nathanpaulscott/IOT-Weather-Station/Datasheets/sunflower schematic.png

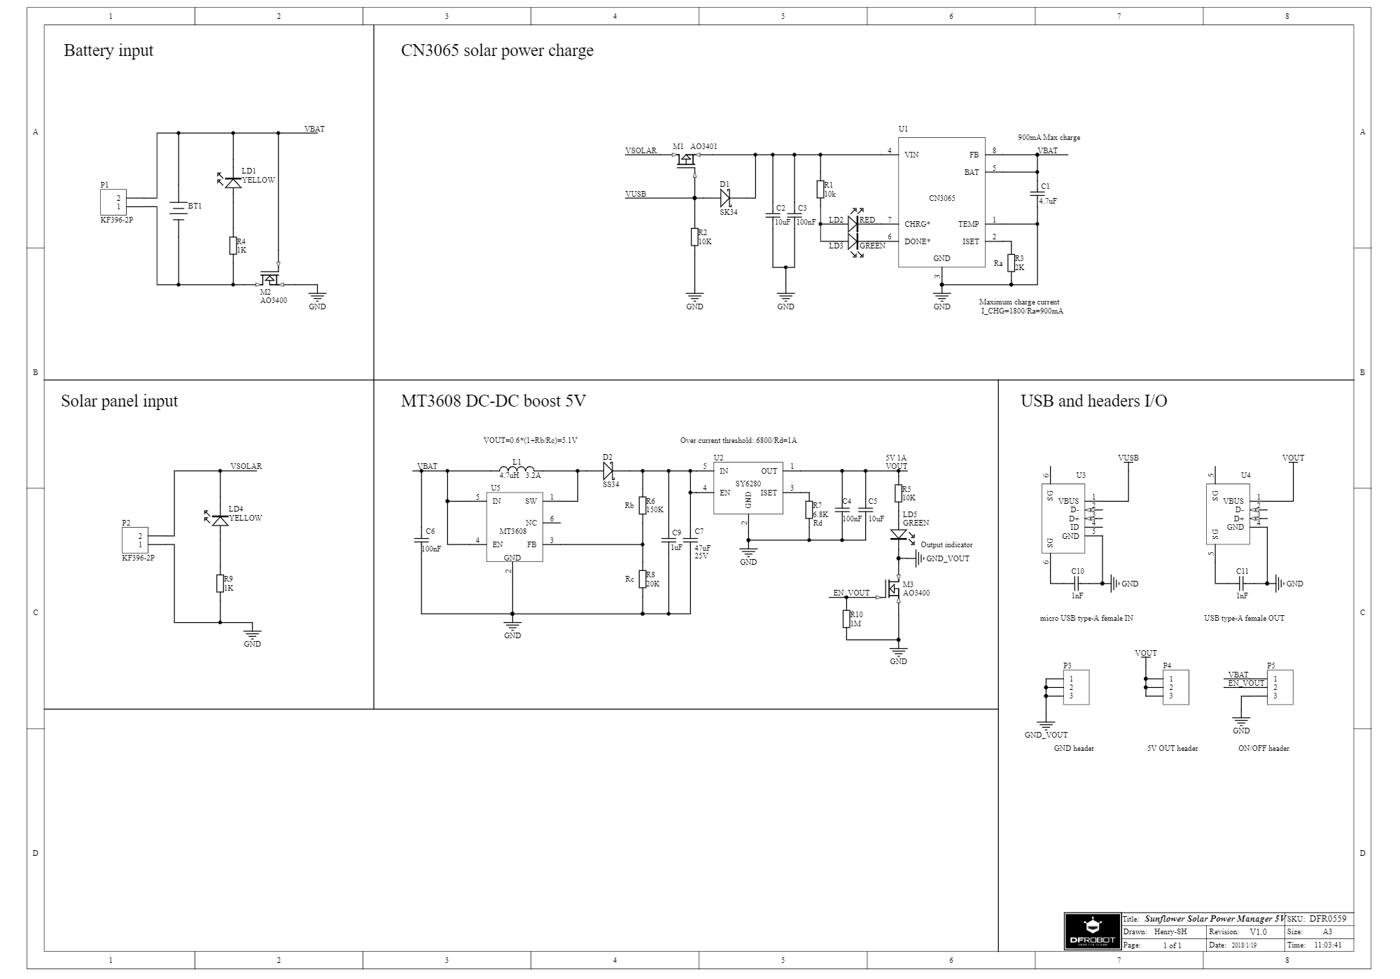
Datasheets/sunflower schematic.png
