nathanpaulscott/IOT-Weather-Station/Report/0a.RP Server.jpg

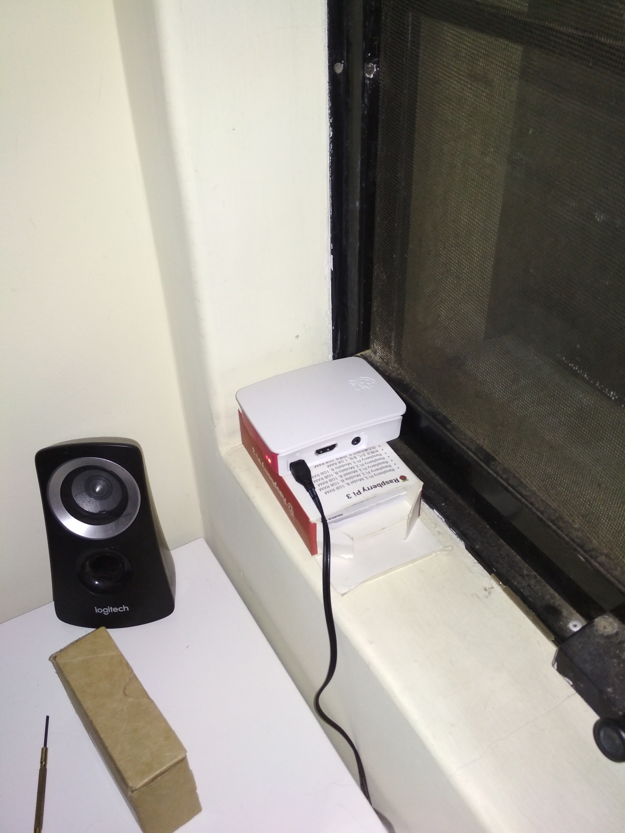
Report/0a.RP Server.jpg
