nathanpaulscott/IOT-Weather-Station/Report/breadboard 1.png

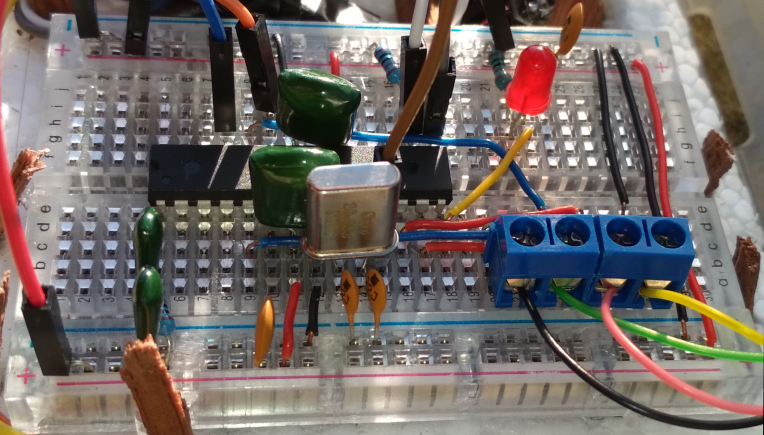
Report/breadboard 1.png
