nathanpaulscott/IOT-Weather-Station/Report/fig1.png

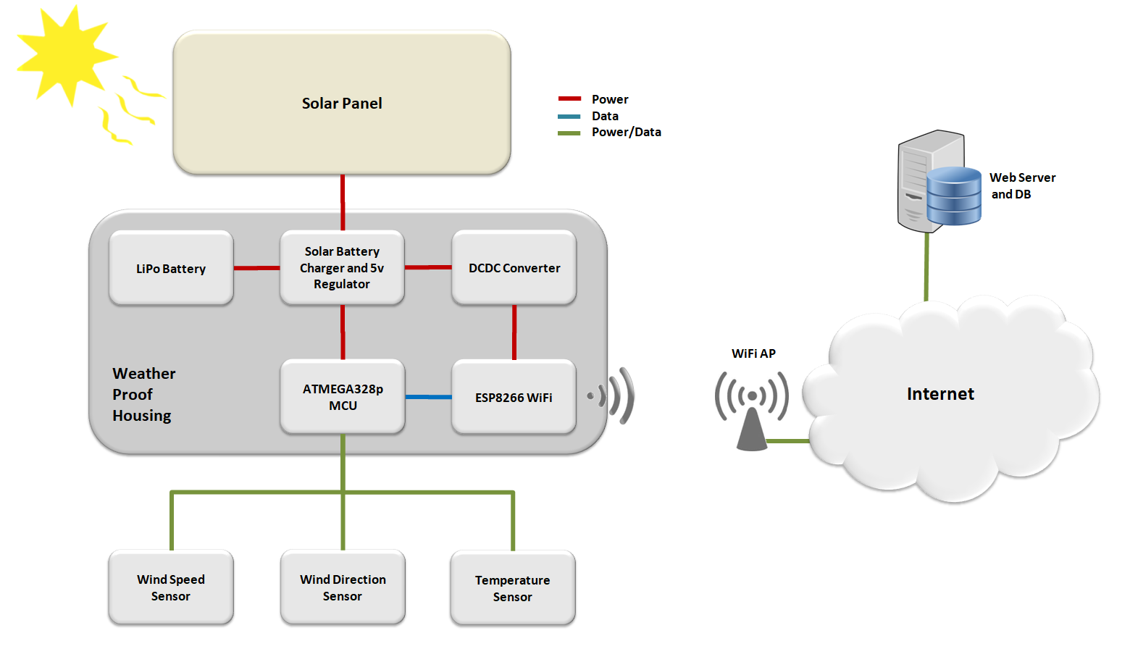
Report/fig1.png
