nathanpaulscott/IOT-Weather-Station/Report/fig2.png

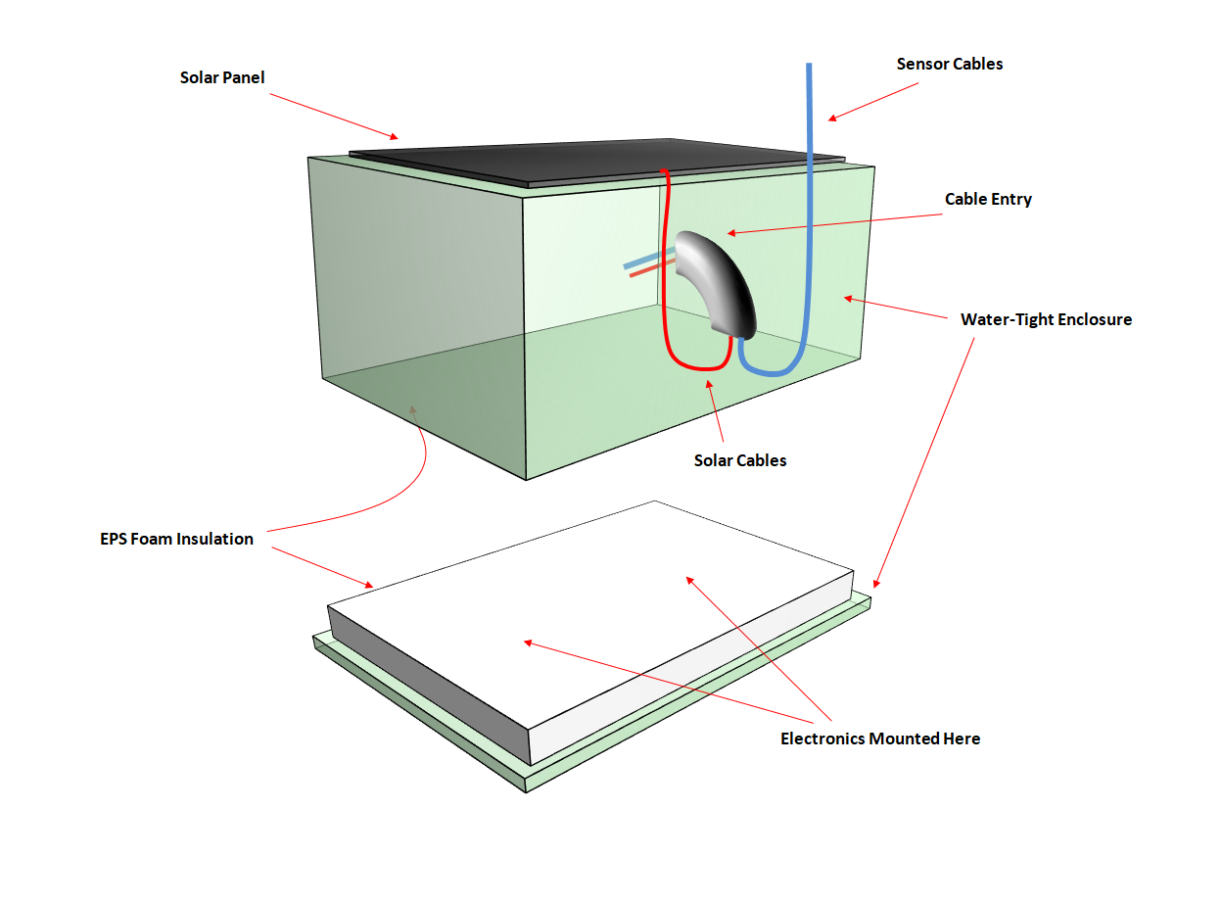
Report/fig2.png
