nathanpaulscott/IOT-Weather-Station/Report/final bat lev and light.png

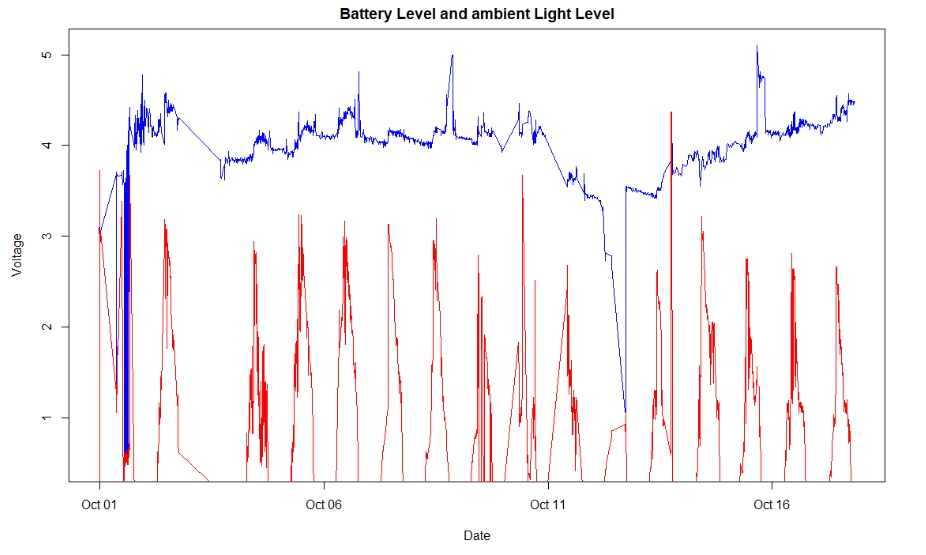
Report/final bat lev and light.png
