nathanpaulscott/IOT-Weather-Station/Report/final temp and hum.png

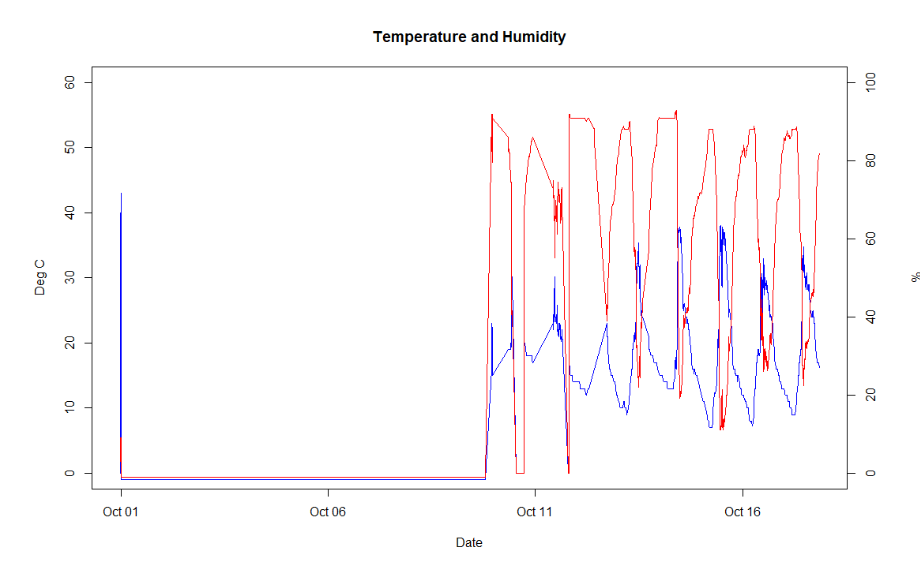
Report/final temp and hum.png
