nathanpaulscott/IOT-Weather-Station/Report/final_w_speed_dir.png

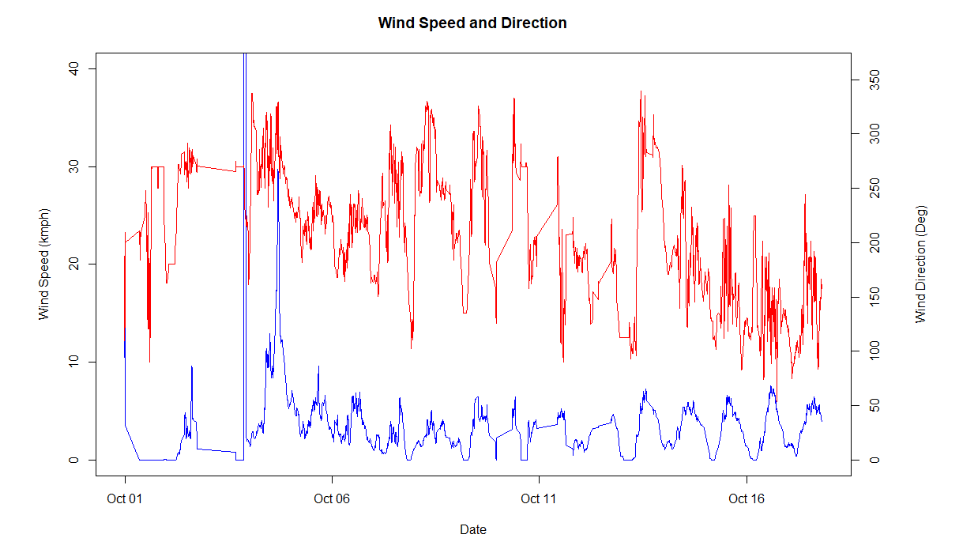
Report/final_w_speed_dir.png
