nathanpaulscott/IOT-Weather-Station/Report/Flowchart.png

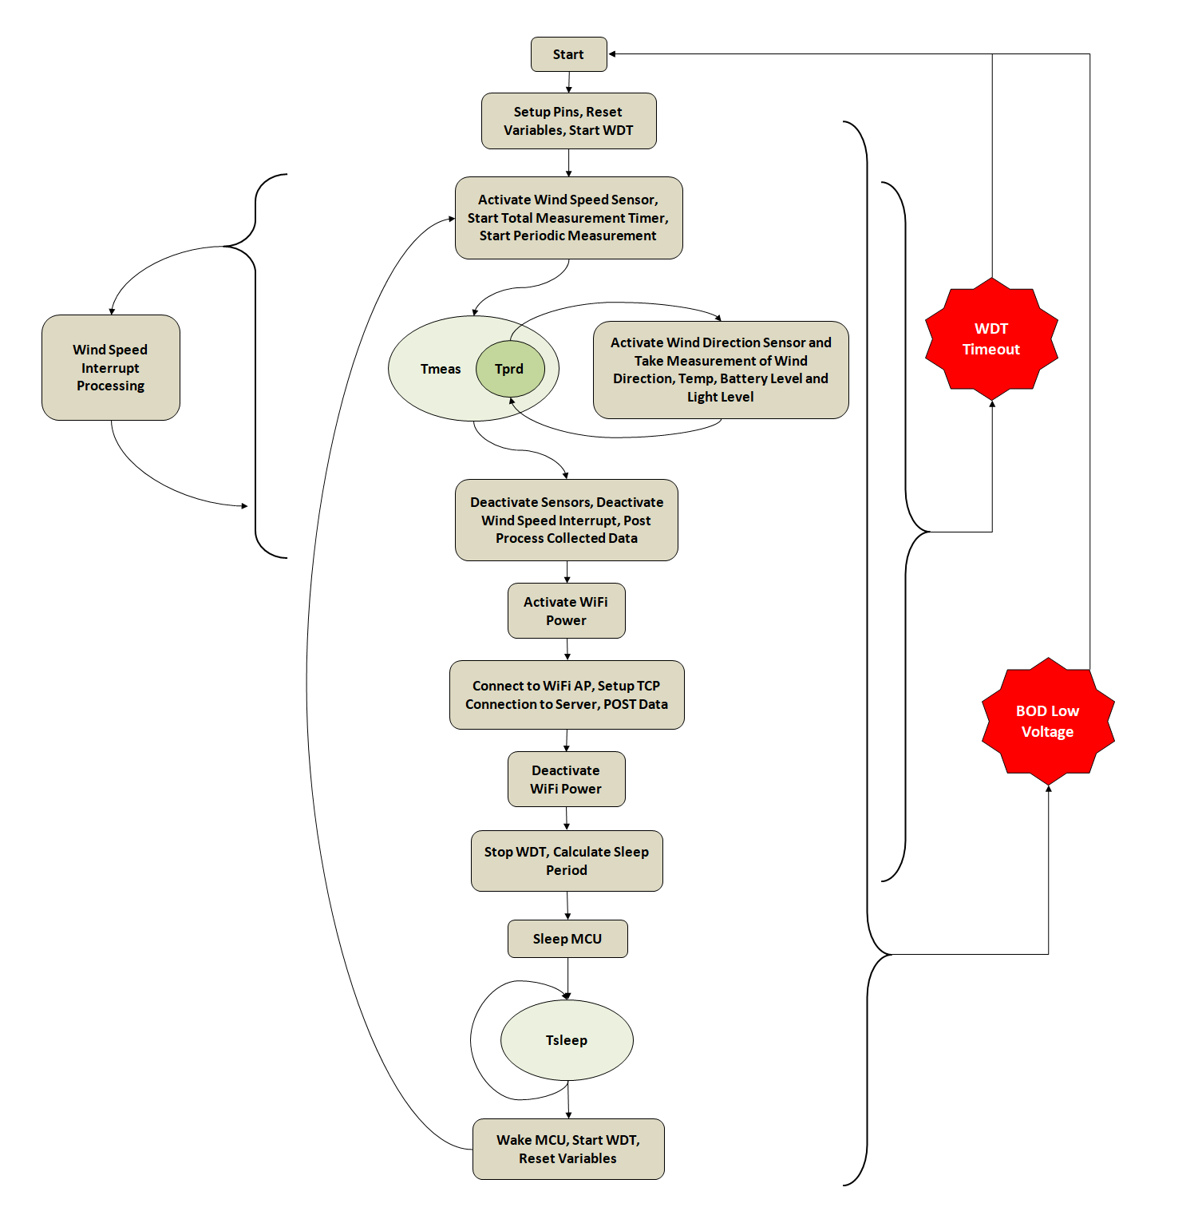
Report/Flowchart.png
