nathanpaulscott/IOT-Weather-Station/Report/frame1.png

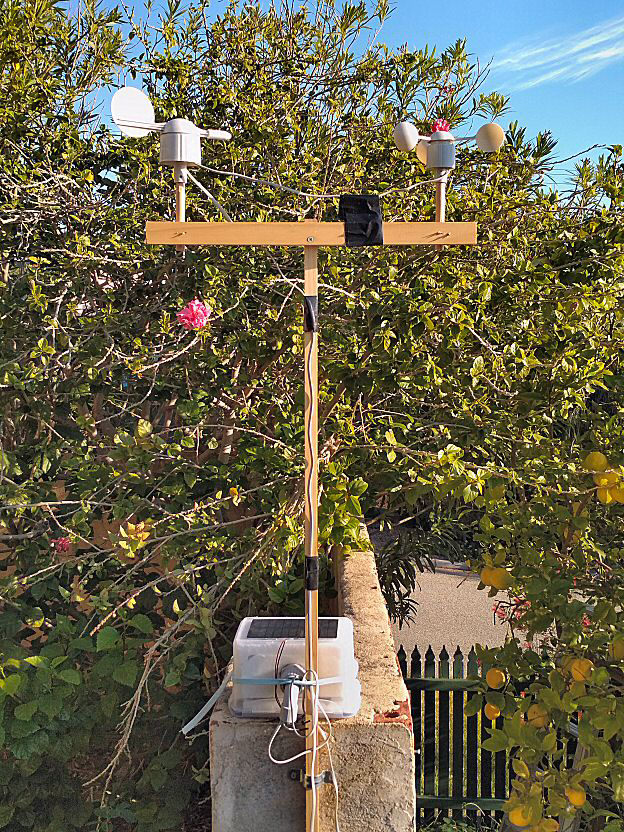
Report/frame1.png
