nathanpaulscott/IOT-Weather-Station/Report/housing open 2.png

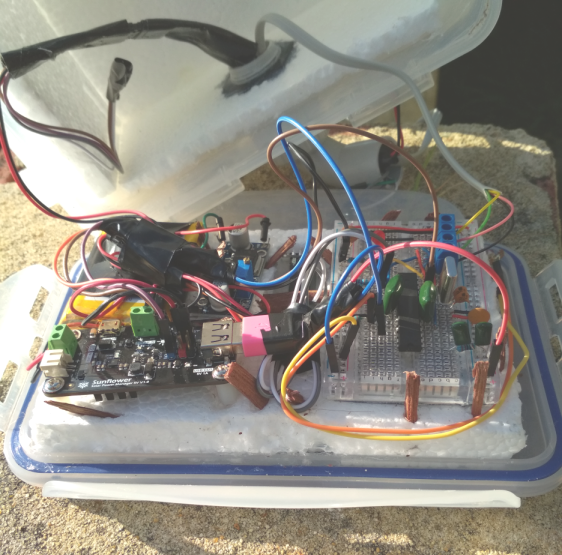
Report/housing open 2.png
