nathanpaulscott/IOT-Weather-Station/Report/whole system top.png

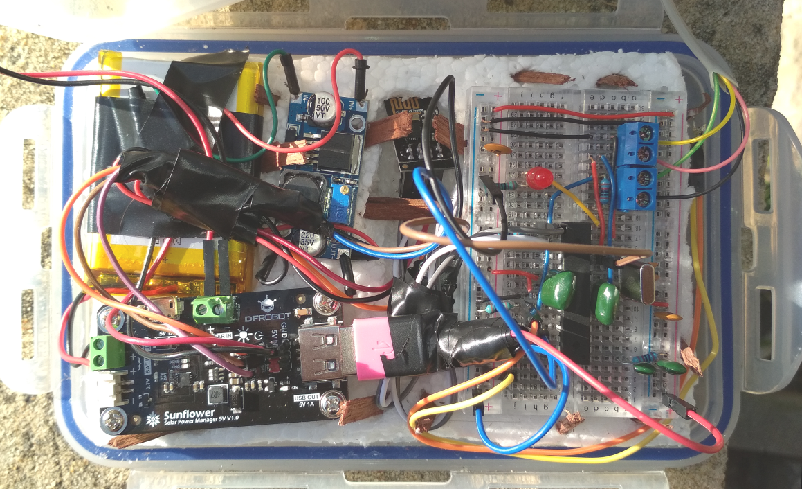
Report/whole system top.png
