nathanpaulscott/IOT-Weather-Station/Report/test.png

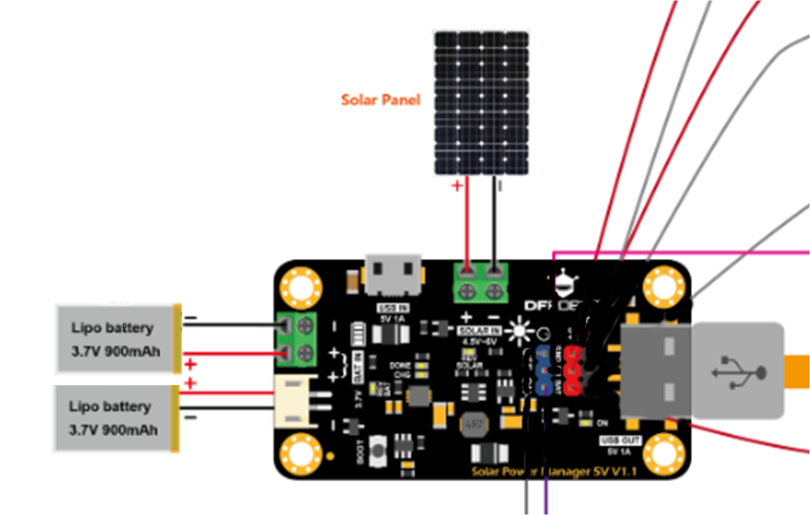
Report/test.png
